makiJanus/robotic_silicone_eye/README.md

# 👁️👁️ Robot Eye Control System

A complete control system for dual animatronic robot eyes — 6 servos per eye (12 total). Includes real-time control, per-axis mirror calibration, expression presets, autonomous movement patterns, a webcam face tracker with random blinking, and an autonomous wander demo that feels alive.

<div align="center">
  <a href="https://www.youtube.com/watch?v=__ouPA_gdw8&lc=Ugzf3y8tP4HDcznU-kN4AaABAg" target="_blank">
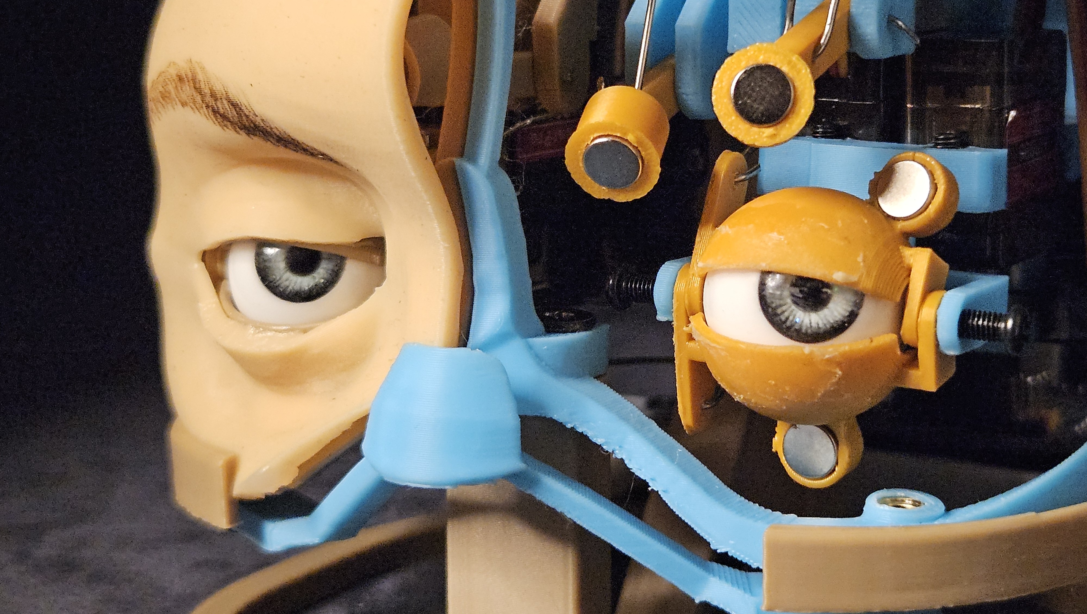
[picture p1: media/thumb_b.jpg]
    
  </a>
  <p><em>Click the image to watch the demo video</em></p>
</div>

## 📋 Table of Contents

- [✨ Features](#-features)
- [🛠️ Hardware Requirements](#️-hardware-requirements)
- [📦 Installation](#-installation)
- [🚀 Quick Start](#-quick-start)
- [📖 Usage Guide](#-usage-guide)
- [🎥 Face Tracker](#-face-tracker)
- [🎬 Wander Demo](#-wander-demo)
- [📁 File Structure](#-file-structure)
- [⚙️ Calibration Data](#️-calibration-data)
- [🔧 Troubleshooting](#-troubleshooting)
- [🎯 Performance Tips](#-performance-tips)
- [🔄 Expanding / Modifying](#-expanding--modifying)
- [📝 License](#-license)
- [🤝 Contributing](#-contributing)
- [📧 Support](#-support)

## 📝 Project Overview

This project provides a complete system for controlling dual animatronic robot eyes with realistic movement patterns and expressions. The system includes both hardware control and software components that work together to create lifelike eye behavior.

## ✨ Features

- **Dual-eye control** — 12 servos (6 per eye: pan, tilt, upper lid, lower lid, brow inner, brow outer)
- **Real-time control** — all 12 sliders work simultaneously with multi-touch support
- **Per-axis mirror calibration** — configure for each axis:
  - Flip (physically mirrored servos)
  - Gain (compensate for mechanical sweep mismatch: left = neutral + flip(delta) × gain)
- **Fast serial protocol** — one batch command updates all 12 servos (~2 ms)
- **Expression presets** — Happy, Sad, Angry, Surprised, Suspicious, Sleepy, Neutral
- **Autonomous patterns** — Saccade, Tracking, Blink, Blink Rapid, Look L/R/U/D, Circle, Dizzy
- **Dedicated Offsets tab** — live per-servo offset tuning
- **Face tracker** — webcam-driven eye movement with random blinking (uses the same calibration)
- **Wander demo** — autonomous "alive" behavior: wandering gaze + cycling expressions + random blinks, all at once
- **Responsive UI** — mobile-friendly, custom touch-friendly sliders
- **Persistent config** — calibration, mirror config, gains, expressions and patterns all saved to JSON

## ✨ Features

- **Dual-eye control** — 12 servos (6 per eye: pan, tilt, upper lid, lower lid, brow inner, brow outer)
- **Real-time control** — all 12 sliders work simultaneously with multi-touch support
- **Per-axis mirror calibration** — configure for each axis:
  - Flip (physically mirrored servos)
  - Gain (compensate for mechanical sweep mismatch: left = neutral + flip(delta) × gain)
- **Fast serial protocol** — one batch command updates all 12 servos (~2 ms)
- **Expression presets** — Happy, Sad, Angry, Surprised, Suspicious, Sleepy, Neutral
- **Autonomous patterns** — Saccade, Tracking, Blink, Blink Rapid, Look L/R/U/D, Circle, Dizzy
- **Dedicated Offsets tab** — live per-servo offset tuning
- **Face tracker** — webcam-driven eye movement with random blinking (uses the same calibration)
- **Wander demo** — autonomous "alive" behavior: wandering gaze + cycling expressions + random blinks, all at once
- **Responsive UI** — mobile-friendly, custom touch-friendly sliders
- **Persistent config** — calibration, mirror config, gains, expressions and patterns all saved to JSON

## 🛠️ Hardware Requirements

### Components

- Arduino (Uno, Mega, Nano, etc.)
- PCA9685 16-channel PWM servo driver
- 12× servos (MG995 or similar 180° servos)
- External 5 V power supply — 5 V, 4 A minimum recommended for 12 servos

### Servo Layout

Each eye uses 6 servos in the same order:

| Per-eye # | Function | Range |
|---:|---|---:|
| 0 | Eye Pan (horizontal) | 0–180° |
| 1 | Eye Tilt (vertical) | 0–180° |
| 2 | Upper Eyelid | 0–180° |
| 3 | Lower Eyelid | 0–180° |
| 4 | Eyebrow Inner | 0–180° |
| 5 | Eyebrow Outer | 0–180° |

### PCA9685 Channel Mapping

| Servo index (in software) | Eye | PCA9685 channel |
|---|---|---:|
| 0–5 | Right eye | 0–5 |
| 6–11 | Left eye | 8–13 |

Channels 6, 7, 14, 15 are unused.

### Wiring Diagram

#### PCA9685 → Arduino

```text
PCA9685      Arduino
  VCC   →    5V
  GND   →    GND
  SCL   →    A5 (or SCL)
  SDA   →    A4 (or SDA)
```

#### PCA9685 → Servos

Each servo:

```text
  + (Red)     → PCA9685 V+  (external 5V supply)
  - (Brown)   → PCA9685 GND
  S (Orange)  → PCA9685 PWM channel
```

> **Important:** Servos must be powered from an external 5 V supply that shares GND with the Arduino. Do not power 12 servos from the Arduino's 5 V rail.

## 📦 Installation

### Option 1: Conda (Recommended)

```bash
# Create environment
conda create -n eye_control python=3.9 -y

# Activate
conda activate eye_control

# Install dependencies
pip install -r requirements.txt
```

### Option 2: Plain pip / venv

```bash
python -m venv venv
source venv/bin/activate          # Windows: venv\Scripts\activate
pip install -r requirements.txt
```

### `requirements.txt`

```text
gradio==4.44.1
huggingface_hub>=0.23,<0.27
pyserial==3.5
numpy==1.24.3
plotly==5.18.0
opencv-python
```

Gradio is pinned to 4.x for Python 3.9 compatibility (Gradio 5/6 require Python 3.10+). On newer Python, you can use Gradio 6 but must move theme= and css= from gr.Blocks(...) to demo.launch(...).

## 🚀 Quick Start Guide

1. **Set up Python Environment**: Create and activate your Python environment using either conda or venv.
2. **Install Dependencies**: Run `pip install -r requirements.txt` to install all required packages.
3. **Upload Arduino Code**: Open `eye.ino` in the Arduino IDE, select your board and port, then upload the sketch.
4. **Run the Application**: Execute `python eye_system.py` to start the control interface.
5. **Access the UI**: Open your browser and navigate to `http://localhost:7860` to access the control panel.

## 🚀 Quick Start

### 1. Upload Arduino Code

Open `eye.ino` in the Arduino IDE.

Select your board and port.

Upload.

### 2. Run the Python Application

```bash
conda activate eye_control
python eye_system.py
```

### 3. Open the UI

Navigate to:

```text
http://localhost:7860
```

### 4. Connect to Hardware

Pick the COM port (Windows) or `/dev/ttyUSB*` (Linux/macOS).

Click 🔗 **Connect**.

Status should read ✅ **Connected to <port>**.

### 5. Calibrate

Recommended order for a fresh setup:

1. ⚙️ **Calibration tab** — set the rest position (Initial) for each of the 12 servos.
2. 🎚️ **Offsets tab** — tune each servo's offset live to align both eyes perfectly at rest.
3. 🎮 **Live Control tab** — flip and gain per axis:
   - Move the right-eye slider; click 🔁 **Apply mirror to LEFT eye**
   - If the left eye moves opposite → toggle that axis's Flip checkbox
   - If the left eye sweeps a different amount → adjust that axis's Gain slider
   - Use 🧪 **Test gain on this axis** for a smooth ±25° sweep on a single axis
   - Click 💾 **Save mirror config** to persist
4. 🎭 **Expressions tab** → click ♻️ **Regenerate Defaults** to rebuild expressions with the new mirror config

## 📖 Usage Guide

<div align="center">
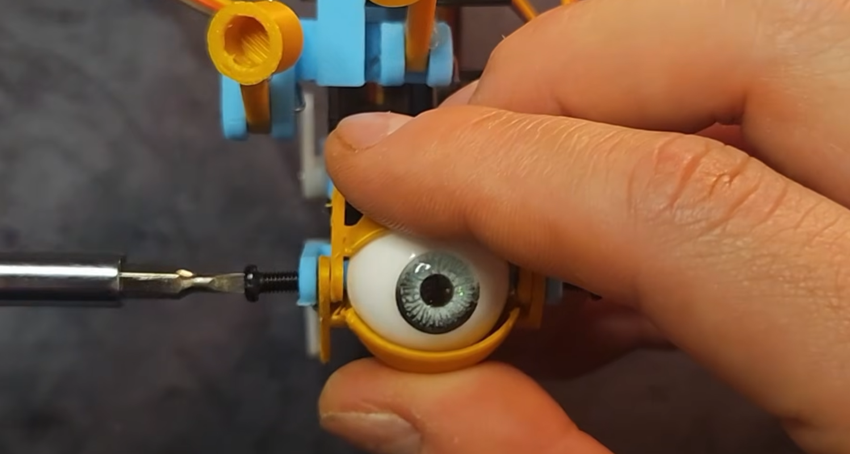
[picture p2: media/build_a.png]
    
</div>

### 🔌 Connection

| Control | Purpose |
|---|---|
| Port dropdown + 🔄 Refresh | Choose and refresh serial ports |
| 🔗 Connect / 🔌 Disconnect | Open/close the serial link |
| 🏠 Go to Rest | Move all 12 servos to their calibrated Initial positions |
| 🎯 Center All | Send 90° to every servo |
| 🔄 Reload Calibration | Re-read `eye_calibration.json` from disk |
| 🔄 Reset All to Defaults | Zero offsets, neutrals back to 90°, mirror config back to defaults |

### 🎮 Live Control

- 12 sliders — 6 right eye, 6 left eye; all work simultaneously
- Flip checkboxes (one per axis) — invert direction when mirroring
- Gain sliders (one per axis) — scale the left eye's sweep vs. right
- 🔁 **Apply mirror to LEFT eye** — copies right-eye pose to left with flip + gain
- 💾 **Save mirror config** — persists flip axes and gains
- 🧪 **Test both axes** — sweeps pan, then tilt on both eyes
- 🧪 **Test gain on this axis** — smooth ±25° sine sweep on a chosen axis (great for tuning gains)

### 🎭 Expressions

- Presets: Neutral, Happy, Sad, Angry, Surprised, Suspicious, Sleepy
- 💾 **Save Expression** — snapshot all 12 angles under a name
- ▶️ **Load Expression** — move to the saved pose
- 🗑️ **Delete Expression** — remove a preset
- ♻️ **Regenerate Defaults** — rebuild built-in expressions with current mirror config and gains

### 🔄 Patterns

| Pattern | Description |
|---|---|
| Saccade | Quick jumps between positions |
| Tracking | Smooth circular-ish motion |
| Blink | Single blink |
| Blink Rapid | Five quick blinks |
| Look Left / Right | Hold eye at an extreme |
| Look Up / Down | Hold at vertical extreme |
| Circle | Smooth circular pan-tilt |
| Dizzy | Layered sin waves, "spinning" look |

Each pattern can be mirrored (checkbox) so the left eye follows using the current flip + gain config.

### 🎚️ Offsets

- 12 sliders — one per servo, live-tune while watching the hardware
- ↺ — reset one offset to 0
- 💾 **Save all offsets** — persist to `eye_calibration.json`
- ↺ **Reset ALL offsets to 0** — zero all offsets in one shot
- Each row shows `Base: X° · Now: Y° · Sent: Z°` so you can see the effective angle

### ⚙️ Calibration

Set Initial (rest/neutral angle) per servo.

These neutrals are used as the pivot point for mirroring, so gains remain valid regardless of where you set rest.

## 🎥 Face Tracker

`face_tracker.py` uses a webcam (OpenCV Haar cascade) to follow a face and adds random blinking between 1–3 seconds.

### Run

```bash
# Preview window (recommended first run)
python face_tracker.py --port COM3

# Headless (e.g. onboard PC on the robot)
python face_tracker.py --port /dev/ttyUSB0 --no-preview
```

Press `q` in the preview or `Ctrl+C` in the terminal to stop. The robot returns to rest on exit.

### Common Options

| Flag | Default | Purpose |
|---|---|---|
| `--port` | (required) | Serial port |
| `--camera` | `0` | Webcam index |
| `--max-pan` | `30.0` | Max pan offset from neutral when face is at the edge of the frame |
| `--max-tilt` | `20.0` | Max tilt offset |
| `--smoothing` | `0.15` | EMA factor (higher = snappier) |
| `--blink-min` | `1.0` | Min seconds between blinks |
| `--blink-max` | `3.0` | Max seconds between blinks |
| `--upper-open` | `65.0` | Right upper lid at full open (matches `_pattern_blink`) |
| `--lower-open` | `110.0` | Right lower lid at full open |
| `--upper-closed` | `90.0` | Right upper lid at full close |
| `--lower-closed` | `90.0` | Right lower lid at full close |
| `--lost-grace` | `1.0` | Seconds before returning to neutral after face lost |
| `--no-preview` | `off` | Run without a camera window |

### Tuning Cheat Sheet

| Want… | Change |
|---|---|
| Eyes to move more per face movement | ↑ `--max-pan` / `--max-tilt` |
| Subtler, calmer tracking | ↓ `--max-pan` to 10–15 |
| Faster reactions | ↑ `--smoothing` to 0.20–0.30 |
| Slower / cinematic | ↓ `--smoothing` to 0.05–0.10 |
| Eyelids close too much | Lower `--upper-closed` (e.g. 85) and/or raise `--lower-closed` (e.g. 95) |

### Calibration Used by the Tracker

The face tracker pulls the following from `eye_calibration.json`:

| Setting | Used? | Where |
|---|---|---|
| Pan/Tilt neutrals | ✅ | pivot for face tracking |
| Brow neutrals | ✅ | brow angles |
| Offsets (all 12) | ✅ | applied on the way to serial |
| Mirror flip (per axis) | ✅ | `mirror_right_to_left` |
| Mirror gains (per axis) | ✅ | `mirror_right_to_left` |

> **Note on eyelids:** the tracker uses its own `DEFAULT_UPPER_OPEN / LOWER_OPEN / UPPER_CLOSED / LOWER_CLOSED` constants (module-level, overridable via CLI) rather than the eyelid neutrals from the calibration file — this is intentional so blinks match the Blink pattern in `eye_system.py`.

## 🎬 Wander Demo

`demo.py` makes the eyes look alive — wandering gaze, cycling expressions, and random blinks, all running at the same time. No interaction needed; it just runs.

### Run

```bash
python demo.py --port COM3
```

Press `Ctrl+C` to stop. The robot returns to rest on exit.

### Options

| Flag | Default | Purpose |
|---|---|---|
| `--port` | (required) | Serial port |
| `--max-pan` | `25.0` | Max pan offset from neutral for wandering |
| `--max-tilt` | `18.0` | Max tilt offset |
| `--blink-min` | `1.5` | Min seconds between blinks |
| `--blink-max` | `4.0` | Max seconds between blinks |
| `--expression-interval` | `8.0` | Average seconds between expression changes |
| `--bias-weight` | `0.3` | How much expressions pull pan/tilt (0–1) |
| `--rate` | `30.0` | Update rate in Hz |

### Presets

```bash
# Default: medium wander, ~8 s expression changes
python demo.py --port COM3

# Wide, expressive: bigger gaze, faster changes
python demo.py --port COM3 --max-pan 35 --max-tilt 24 --expression-interval 6

# Calm / contemplative: small gaze, long dwells
python demo.py --port COM3 --max-pan 15 --expression-interval 12

# Hyperactive: fast reactions, high rate
python demo.py --port COM3 --rate 60 --max-pan 30 --expression-interval 5
```

### How It Works

Three independent engines run in parallel; their outputs are merged every tick:

```text
┌──────────────────────────────────────────────────────────────┐
│  WANDER ENGINE         → pan_offset, tilt_offset             │
│  (saccades, holds,     → owns pan/tilt base                  │
│   micro-jitter)                                               │
├──────────────────────────────────────────────────────────────┤
│  EXPRESSION ENGINE     → 6-axis pose, name                   │
│  (random picker +      → brows fully; small pan/tilt bias    │
│   ease-in transitions) → eyelid deltas                       │
├──────────────────────────────────────────────────────────────┤
│  BLINK ENGINE          → blink_amount (0..1)                 │
│  (random + optional    → pulls eyelids toward closed         │
│   double-blink)        → frequency scaled per expression     │
└──────────────────────────────────────────────────────────────┘
                          ↓
                   Compose per tick
                          ↓
        mirror_right_to_left(...) → send_batch_command(...)
```

Per tick:

```text
pan      = neutral_pan  + wander_pan  + expr_pan_bias × bias_weight
tilt     = neutral_tilt + wander_tilt + expr_tilt_bias × bias_weight

upper_lid = neutral_upper + (expr_upper − 90) × eyelid_weight
            ↳ blink pulls toward 90 (never overshoots)
lower_lid = neutral_lower + (expr_lower − 90) × eyelid_weight
            ↳ blink pulls toward 90 (never overshoots)

brow_in   = expr_brow_in     (expression drives brows fully)
brow_out  = expr_brow_out
```

### Key Design Points

- **Ease-in expression transitions** — expressions blend over ~0.5 s with t² easing; no abrupt jumps.
- **Blink respects expressions** — if the current expression is Sleepy (lids already closed), blinks don't punch past closed. The blink interpolates from the expression's pose toward the closed pose, not from wide-open.
- **Per-expression blink frequency** — Sleepy blinks ×2, Surprised blinks ×0.6, etc. (tunable in `BLINK_FREQ_MULT` at the top of `demo.py`).
- **Micro-saccades during holds** — tiny ±1.5° jitter between big saccades makes the eye feel alive.
- **Double-blinks** — 15% chance a blink is followed by a second one 100–220 ms later.
- **No return to neutral** — the expression engine blends directly from current → new; feels more natural than passing through Neutral.

### Tuning Cheat Sheet

Most knobs live in the `TUNABLES` section at the top of `demo.py`:

| Want… | Change |
|---|---|
| Snappier saccades | Lower `WANDER_SACCADE_MAX` to 0.10 |
| Longer dwell between jumps | Raise `WANDER_IDLE_MIN / MAX` |
| More "shifty" eyes | Raise `JITTER_PAN` to 2.5 |
| Calmer eyes | Raise `WANDER_IDLE_MIN` to 2.5 |
| Blinks feel too frequent | Raise `--blink-min` / `--blink-max` |
| Expressions change too often | Raise `--expression-interval` |
| Expressions barely affect the eyes | Raise `--bias-weight` (e.g. 0.5) |
| Less cross-talk wander vs. expression | Lower `--bias-weight` |
| Saccades look choppy | Raise `--rate` (e.g. 60) |

### Calibration Used by the Demo

Same as the face tracker:

| Setting | Used? |
|---|---|
| Pan/Tilt/Brow neutrals | ✅ |
| Offsets (all 12) | ✅ |
| Mirror flip (per axis) | ✅ |
| Mirror gains (per axis) | ✅ |
| Eyelid neutrals | ⚠️ used as baseline; expression eyelid values are applied as deltas from 90, so tune `EXPR_EYELID_REF` / `EXPR_EYELID_WEIGHT` if your calibration drifts far from 90 |

## 📁 File Structure

```text
eye_control_system/
├── eye_system.py           # Main Gradio application
├── face_tracker.py         # Webcam face tracker with random blinks
├── demo.py                 # Autonomous "alive" wander demo
├── eye.ino                 # Arduino firmware (PCA9685 driver)
├── requirements.txt        # Python dependencies
├── README.md               # This file
├── LICENSE                 # License file
├── eye_calibration.json    # Auto-generated: neutrals, offsets, mirror config + gains
├── eye_expressions.json    # Auto-generated: expression presets
└── eye_patterns.json       # Auto-generated: movement patterns
```

## ⚙️ Calibration Data

`eye_calibration.json` is the single source of truth for the whole system — the app, the face tracker, and the wander demo all read it on startup.

```json
{
  "initial_positions": [90, 90, 90, 90, 90, 90, 90, 90, 90, 90, 90, 90],
  "offsets":           [0, 0, 0, 0, 0, 0, 0, 0, 0, 0, 0, 0],
  "mirror_axes":       [false, true, true, true, true, true],
  "mirror_gains":      [1.0, 1.0, 1.0, 1.0, 1.0, 1.0],
  "servo_names":       ["R Eye Pan", "R Eye Tilt", "..."],
  "timestamp":         "2025-01-01 12:00:00"
}
```

### Mirror Formula

For each of the 6 axes (index i = 0..5):

```text
delta       = right_angle - right_neutral[i]
if mirror_axes[i]: delta = -delta
delta      *= mirror_gains[i]
left_angle  = clamp(left_neutral[i] + delta, 0, 180)
```

### What Each Field Controls

- `initial_positions` — rest/neutral angle for each servo (pivots for mirroring)
- `offsets` — added to the logical angle before sending to hardware: `sent = logical + offset`
- `mirror_axes` — flip true/false per axis
- `mirror_gains` — sweep scaling per axis (used only on the left eye)

The file is written with `os.replace` (atomic on Windows and Linux), so backups (`*.json.backup`) are safe to overwrite on every save.

## 📁 CAD Files

You can download the cad files on Fusion360 and Step formats on this link:
<div align="center">
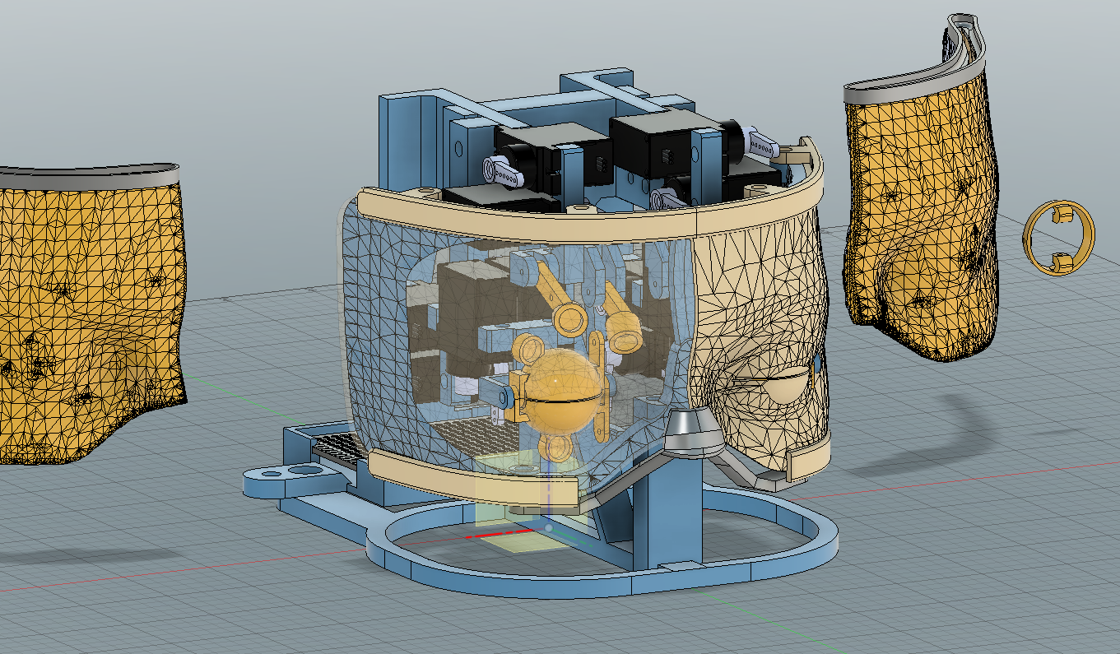
[picture p3: media/cad.png]
Emotion Visualizer
  
</div>

### Eye Left
- [Fusion 360 Archive (.f3d)](https://drive.google.com/file/d/1sPjkrsWElwknj-bEWVMCnOmQxAXvLe6D/view?usp=sharing)
- [STEP File (.step)](https://drive.google.com/file/d/1brXJCzBTI_8S5b5Gdz2TChhcHL2v2E58/view?usp=sharing)

### Eye Right
- [Mold Fusion 360 (.f3d)](https://drive.google.com/file/d/1zNk5UFjyafX2VUT7yIcKwBQZY1irVLjd/view?usp=sharing)
- [Mold STEP File (.step)](https://drive.google.com/file/d/1LCd8bpS2u_AIFLCp0Ksmfnem69Cgfole/view?usp=sharing)

### Mold
- [Mold Fusion 360 (.f3d)](https://drive.google.com/file/d/1-iyC8ygJUOypd4tcz0lyhWBCPZDkuMqf/view?usp=sharing)
- [Mold STEP File (.step)](https://drive.google.com/file/d/122887qXR6liP_XLuxUf3ikimA066I-pq/view?usp=sharing)

### Support
- [Mold Fusion 360 (.f3d)](https://drive.google.com/file/d/1KIUX7daLbmSGbM61Y7DuquAxZn_WgxXi/view?usp=sharing)
- [Mold STEP File (.step)](https://drive.google.com/file/d/1tx2MDzFTQaWjOZ53SIb17_PjQfeoTO7M/view?usp=sharing)
---

## 📦 Materials List

| Component | Quantity | Notes |
|---|---|---|
| **Servos** | | |
| SG90 Micro Servo | 6/12 | For one/two eyes |
| **Screws & Hardware** | | |
| M3 Screws | Various | Lengths: 6mm, 8mm, 10mm |
| M4 Screws | Various | Lengths: 10mm, 12mm, 16mm |
| M3 Nuts | Various |  |
| M4 Nuts | Various |  |
| **Electronics** | | |
| Webcam | 1 |  |
| Arduino Nano | 1 | Microcontroller |
| PCA9685 Servo Driver | 1 | 16-channel PWM driver |
| 5x7cm Perforated PCB | 1 | For soldering components |
| On-Off button | 1 | 16mm diamater |
| Screw Terminal Block |  | The 2 inputs one |
| 5-6V Power Supply | 1 | 2A+ for all servos |
| USB 2.0 Cable | 1 | For Arduino |
| **3D Printing** | | |
| PLA Filament | 1 kg | Any color |
| **Tools** | | |
| Soldering Iron | 1 | With fine tip |
| Solder | 1 | 0.8mm-1.0mm |
| Wire Cutters | 1 | |
| Screwdriver Set | 1 | Phillips & Flathead |
| Silicone Solution A+B | 1 (Pair) | 5A Shore |

---

## 🔧 Troubleshooting

### `ImportError: cannot import name 'HfFolder' from 'huggingface_hub'`

Pin `huggingface_hub` to `<0.27`:

```bash
pip install "huggingface_hub>=0.23,<0.27"
```

### `TypeError: __init__() got an unexpected keyword argument 'scale' on gr.Markdown`

You're on Gradio 4.x — `gr.Markdown` doesn't accept scale. Wrap it in a `gr.Column(scale=N)` instead, or remove `scale=`.

### `TypeError: launch() got an unexpected keyword argument 'theme'`

You're on Gradio 4.x or 5.x — theme and css belong on `gr.Blocks(...)`, not on `demo.launch(...)`. (On Gradio 6.x it's the opposite.)

### `AttributeError: 'EyeController' object has no attribute 'save_calibration'`

Your `eye_system.py` is missing the `save_calibration` method. Restore it inside the `EyeController` class.

### `AttributeError: 'BlinkEngine' object has no attribute '_freq_mult'`

Ordering bug — `_freq_mult` must be set before `_random_interval()` is called in `BlinkEngine.__init__`. Move the `_freq_mult = 1.0` initialization above the `_next_blink` assignment.

### Saved gains don't persist / second save silently fails on Windows

Cause: using `os.rename` for backups raises `FileExistsError` on Windows when the `.backup` file already exists. Use `os.replace` in `save_calibration`, `save_expressions_file`, and `save_patterns_file`.

### `KeyError: '6'` when loading expressions

Expression file was written when the project was single-eye. Delete `eye_expressions.json` and restart, or open the app and click ♻️ **Regenerate Defaults**.

### Serial Connection Issues

#### Linux — add user to `dialout` group

```bash
sudo usermod -a -G dialout $USER
```

#### Linux — check port permissions

```bash
ls -la /dev/ttyUSB*
sudo chmod 666 /dev/ttyUSB0      # replace with your port
```

#### Windows — COM port lookup

Open Device Manager → Ports (COM & LPT) and note the port.

#### Port already in use

```bash
# Linux/Mac
lsof /dev/ttyUSB0
kill -9 [PID]
```

Windows: use Device Manager or restart.

### Servo Not Moving

- Verify servos have an external 5 V supply (not the Arduino rail)
- Check PCA9685 I2C address (default `0x40`)
- Verify the servo signal wires go to the channels in the mapping table
- Click 🎯 **Center All** first — if nothing moves, it's a hardware issue

### Conda Environment Issues

```bash
conda update conda
conda env remove -n eye_control
conda create -n eye_control python=3.9 -y
conda activate eye_control
pip install -r requirements.txt
```

## 🎯 Performance Tips

- **Batch protocol** — all 12 servos are updated in a single `P,...` serial command
- **Change detection** — the UI skips serial writes when nothing moved by ≥ 1°
- **Background threads** — patterns, face tracker, and demo engines run off the UI thread
- **Multi-touch** — sliders don't block each other
- **Smoothing (`--smoothing`)** — tune the tracker's EMA to trade latency for smoothness
- **Offset cache** — offsets are applied in memory before serializing, no extra round-trips
- **Tick rate (`--rate`)** — the wander demo defaults to 30 Hz; raise to 60 Hz if saccades look choppy on your hardware

## 🔄 Expanding / Modifying

### Change the Servo Count

Update `NUM_SERVOS` in both `eye.ino` and `eye_system.py`, then extend `SERVO_NAMES`. The batch protocol, calibration JSON and UI all derive from these.

### Change the PCA9685 Channel Mapping

Edit the `SERVO_CHANNELS` array at the top of `eye.ino` — it maps software servo index (0..N−1) to physical PCA9685 channel.

### Add a New Pattern

Add a method `_pattern_<name>(self, mirror=True)` to `EyeController`.

Add it to `_default_patterns()` (description) and to the dispatch dict in `_pattern_worker`.

### Add a New Expression

Just save it from the UI, or add it to `right_eyes` in `_default_expressions()` (left eye is auto-mirrored).

### Tweak the Demo's Personality

All the "feel" constants are grouped at the top of `demo.py` under `# TUNABLES`:

- `WANDER_*` — saccade timing, dwell durations
- `JITTER_*` — micro-saccade amplitude and frequency
- `BLINK_*` — blink close/hold/open timings
- `BLINK_FREQ_MULT` — per-expression blink frequency
- `EXPR_TRANSITION` — expression blend duration
- `EXPR_EYELID_REF / EXPR_EYELID_WEIGHT` — how expression eyelids map onto calibration

The CLI exposes only the 8 most frequently changed knobs.

### Combine Tracker + Demo (Future Idea)

The wander engine in `demo.py` is a drop-in candidate to be swapped for a face-aware wander engine: when a face is detected, follow it; when not, fall back to wandering. Since all three engines write to independent variables and are composed in `run_tick`, this is a localized change.

## 📝 License

This project is licensed under the MIT License — see the `LICENSE` file for details.

## 🤝 Contributing

Contributions are welcome! Please open a Pull Request or file an issue.

## 📧 Support

- Check the Troubleshooting section first
- Open an issue on GitHub with the full console output and the contents of `eye_calibration.json` (feel free to redact timestamps)
- Confirm your Python version (`python --version`), Gradio version (`pip show gradio`), and OS

## 🙏 Acknowledgements

This project was inspired by various animatronic eye control systems and aims to provide an accessible, open-source solution for creating lifelike robot eyes. Special thanks to the open-source community for their contributions to Python, Arduino, and computer vision libraries.

## 📚 References

- [Gradio Documentation](https://gradio.app/)
- [Arduino PCA9685 Library](https://github.com/adafruit/Adafruit-PWM-Servo-Driver-Library)
- [OpenCV Haar Cascades](https://docs.opencv.org/4.x/db/d28/tutorial_cascade_classifier.html)
