makiJanus/robotic_silicone_eye/(commit log)

2026-09-11 Update to cotnrol left and right eye independently. Added new expressions and calibration files. Updated requirements.txt to include new dependencies.
2026-09-19 Added imgs, cad links, and materials on README
